MakerMatrix/IndyMill/IndyController/changelog.txt

04.11.2021:
OR gate added to the diag pins and connected to the microcontroller. Thicker traces for VIN and some signals. Now it's just about perfecting the design and adding more features.

31.10.2021:
I simplified the whole schematic and got rid of additional screw terminals for external stepper drivers, start, hold and resum buttons (to have some additional free pins on the microcontroller). I will use those pins to handle DIAG pins of the drivers, there will be an OR gate for X, Y1 and Z axis as we will home only one at a time but Y2 will be connected separetely so that we can properly square the CNC.
I started routing some more components on the PCB, it's going well.

4.10.2021:
I just thought that it may be a good idea to just note down the thoughts while designing this project. Here I will write down what I changed, new ideas and other stuff connected to the IndyController.

For the last few days I have been thinking about it a lot, I think I am going to change the concept and instead of designing a controller board for IndyMill I will design a new controller board for smaller CNC machines like Dremel CNC and in the future a new CNC that I want to start working on. IndyShield is good enough for IndyMill. By implementing TMC drivers I can simplify the construction of a CNC create a really inteligent control board powered with 24V. I will have to customize GRBL quite a lot.
