MakerMatrix/IndyMill/IndyController/parts.ods

Name | Value | Amount | Link | Comment
CH340G | - | 1 | https://lcsc.com/product-detail/USB-ICs_WCH-Jiangsu-Qin-Heng-CH340G_C14267.html
USB B socket | - | 1 | https://lcsc.com/product-detail/span-style-background-color-ff0-USB-span-Connectors_Ckmtw-Shenzhen-Cankemeng-U-USBBR04P-F000_C189733.html
Resistor (0603) | 10k | 3
Capacitor (0603) | 10uF | 1
Electrolytic capacitor | 10uF | 2 | https://lcsc.com/product-detail/Aluminum-Electrolytic-Capacitors-Leaded_PANASONIC-ECEA1VKS100_C713348.html
Screw Terminal | 4 pin | 3 | https://lcsc.com/product-detail/Screw-terminal_JILN-JL301-50004U01_C1509680.html
Screw Terminal | 3 pin |  | https://lcsc.com/product-detail/Screw-terminal_JILN-JL301-50003U01_C395215.html
Screw Terminal | 2 pin |  | https://lcsc.com/product-detail/Screw-terminal_JILN-JL301-50002U02_C395214.html
FDN340P P MOSFET |  | 1 | https://lcsc.com/product-detail/MOSFETs_UMW-Youtai-Semiconductor-Co-Ltd-FDN340P_C347510.html
LM358D opamp |  | 2 | https://lcsc.com/product-detail/Operational-Amplifier_IDCHIP-LM358D_C688858.html
Crystal 16MHz
Crystal 12MHz
Fuse holder | 5x20mm | 1 | https://www.lcsc.com/product-detail/span-style-background-color-ff0-Fuse-span-Holders_Littelfuse-0PTF0078P_C2760101.html
Fuse 500mA 5x20mm | 5x20mm | 1 | https://www.lcsc.com/product-detail/Fuses_Littelfuse-0217-500MXP_C142795.html
Fuse 2A 5x20mm | 5x20mm | 1 | https://www.lcsc.com/product-detail/Fuses_Littelfuse-0218002-MXP_C142702.html
Polarity protection diode | 40V, 1A | 1 | https://www.lcsc.com/product-detail/Schottky-Barrier-Diodes-SBD_Diodes-Incorporated-B140-13-F_C15759.html
5V regulator IFX27001TF V50 |  | 1 | https://www.lcsc.com/product-detail/Linear-Voltage-Regulators-LDO_Infineon-Technologies-IFX27001TF-V50_C152661.html
3.3V regulator LP2985-33DBVR |  | 1 | https://www.lcsc.com/product-detail/Linear-Voltage-Regulators-LDO_Texas-Instruments-LP2985-33DBVR_C95414.html
12V regulator LM3480IM3-12/NOPB | 12V, 100mA | 1 | https://www.lcsc.com/product-detail/Linear-Voltage-Regulators-LDO_Texas-Instruments-LM3480IM3-12-NOPB_C130175.html
TMC2226-SA-T | 2A | 4 | https://lcsc.com/product-detail/Motor-Driver-ICs_TRINAMIC-Motion-Control-GmbH-TMC2226-SA-T_C705366.html
JST Connector | 2 pin | 5 | https://lcsc.com/product-detail/Wire-To-Board-Wire-To-Wire-Connector_BOOMELE-Boom-Precision-Elec-C24194_C24194.html
OR JST Connector | - | - | https://lcsc.com/product-detail/Wire-To-Board-Wire-To-Wire-Connector_BOOMELE-Boom-Precision-Elec-C24192_C24192.html
OR JST Connector | - | - | https://lcsc.com/product-detail/Wire-To-Board-Wire-To-Wire-Connector_BOOMELE-Boom-Precision-Elec-C57141_C57141.html
JST Connector | 3 pin | 1 | https://lcsc.com/product-detail/Wire-To-Board-Wire-To-Wire-Connector_BOOMELE-Boom-Precision-Elec-C95019_C95019.html
OR gate | 3 inputs | 1 | https://lcsc.com/product-detail/Gates_Texas-Instruments-SN74LVC1G332DBVR_C43368.html
ADDITIONAL | 2 pin | a lot | https://lcsc.com/product-detail/Rectangular-Connectors-Housings_BOOMELE-Boom-Precision-Elec-XHB-2Y_C57102.html
ADDITIONAL | 2 pin | a lot | https://lcsc.com/product-detail/Rectangular-Connectors-Housings_BOOMELE-Boom-Precision-Elec-XH-2Y_C8677.html
