MakerMatrix/IndyMill/3D Printed/X axis nut holder.stl

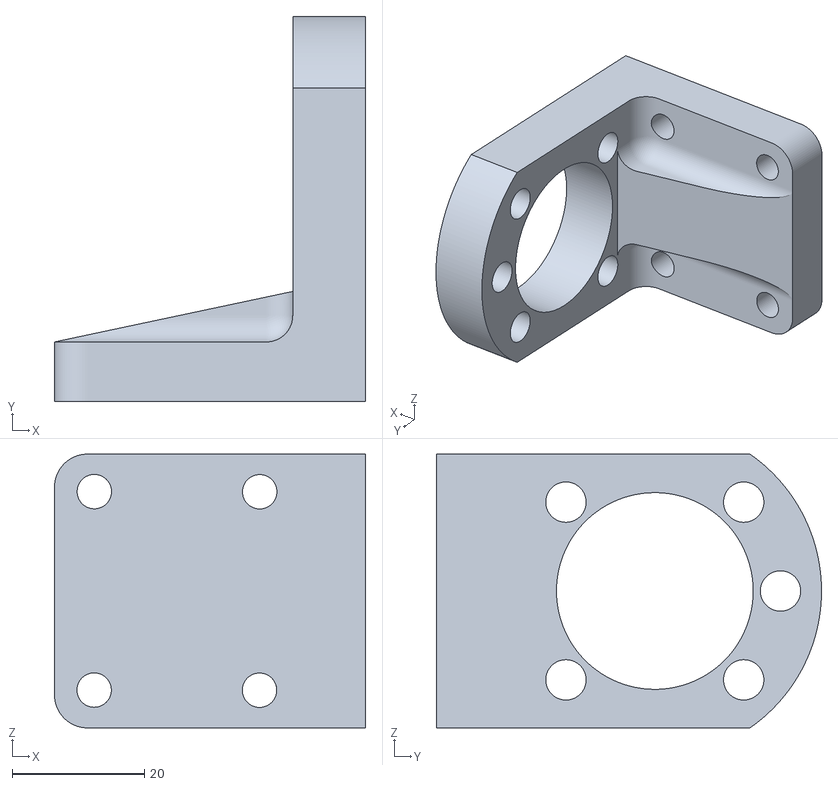
[picture p1: CAD file, 2022-02-04]
3D Printed/X axis nut holder.stl
47.0 x 58.2 x 41.4
