MakerMatrix/IndyMill/IndyController/1811131826_Ckmtw-Shenzhen-Cankemeng-U-USBBR04P-F000_C189733.pdf

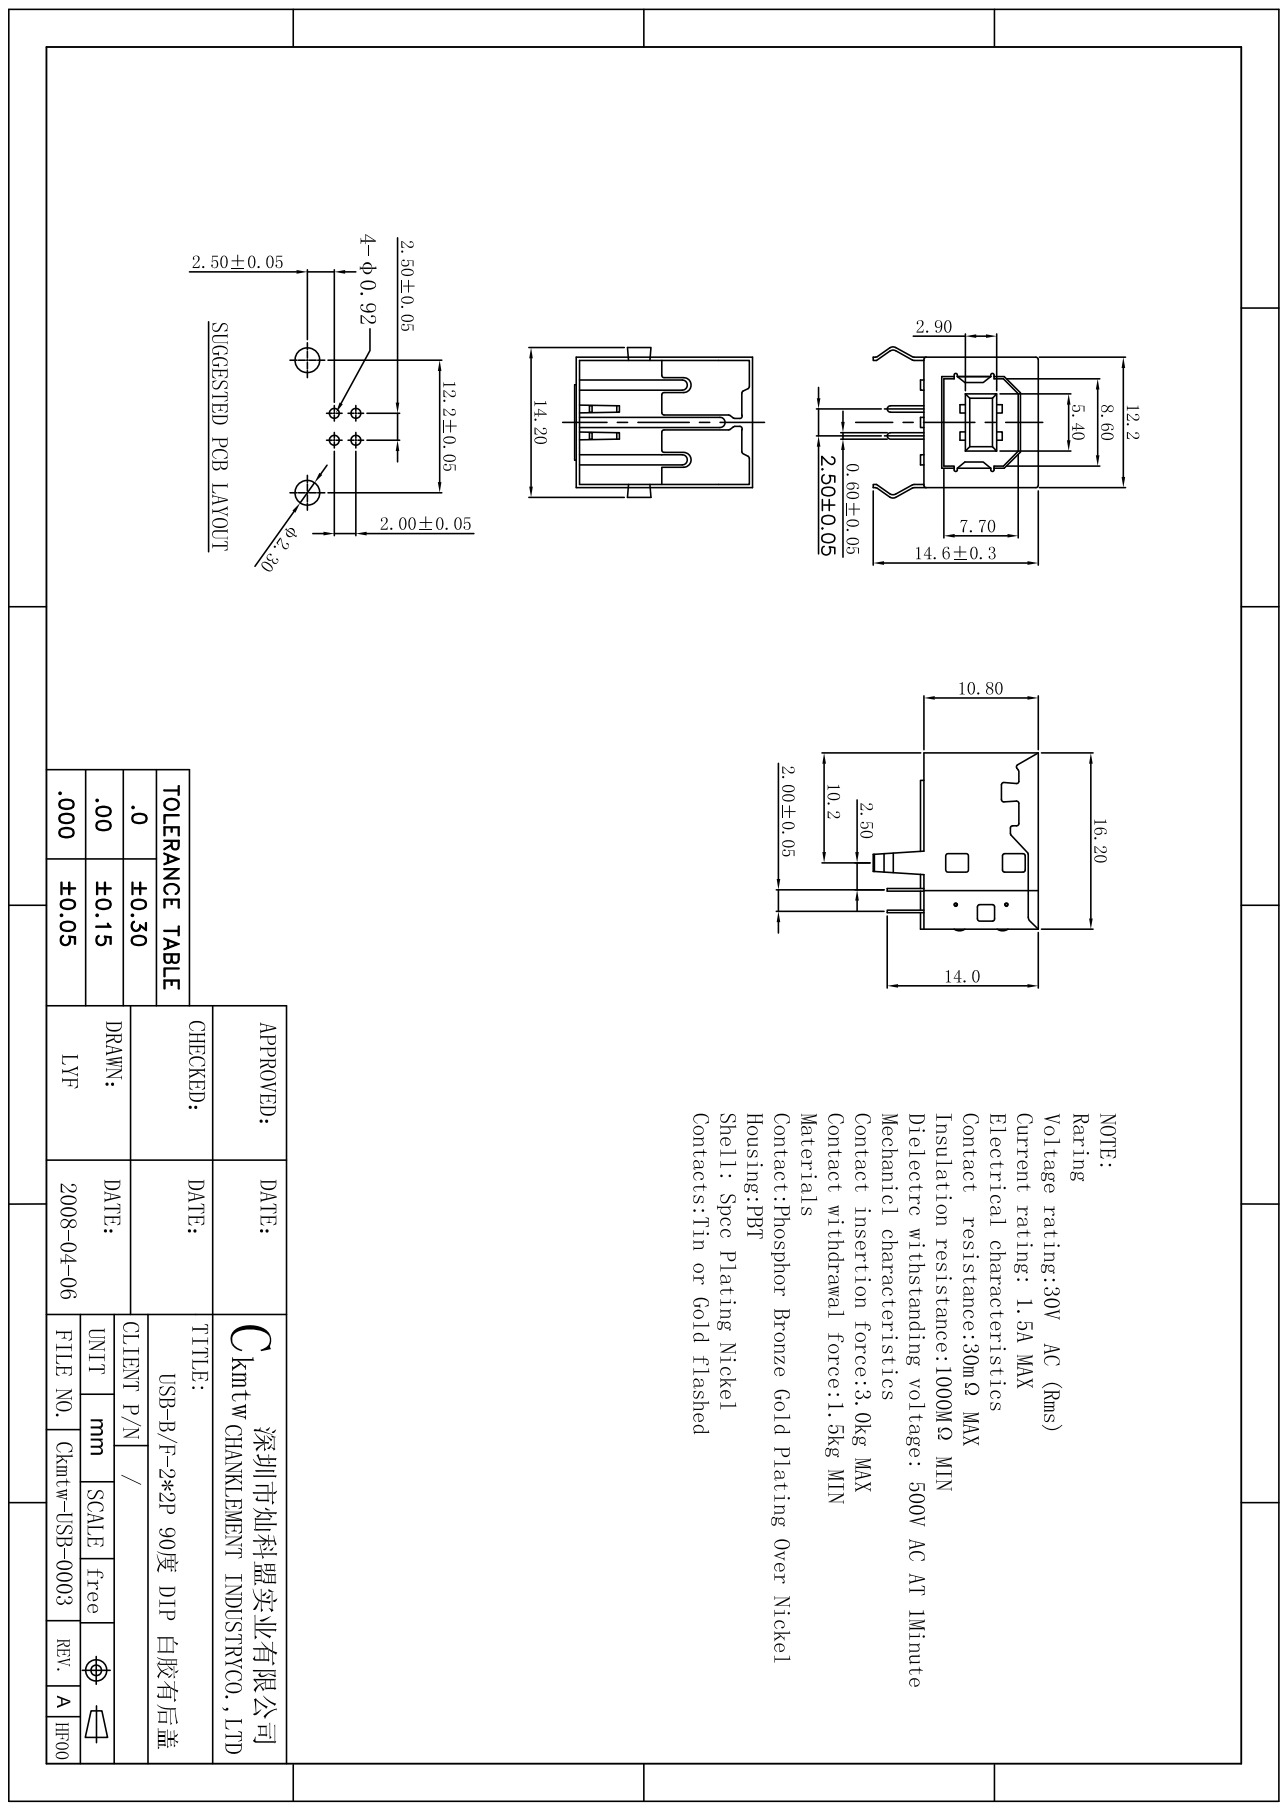
[picture p2: page 1]
