MakerMatrix/IndyMill/IndyController/schematic.brd

## EAGLE design IndyController/schematic.brd (2021-11-05)

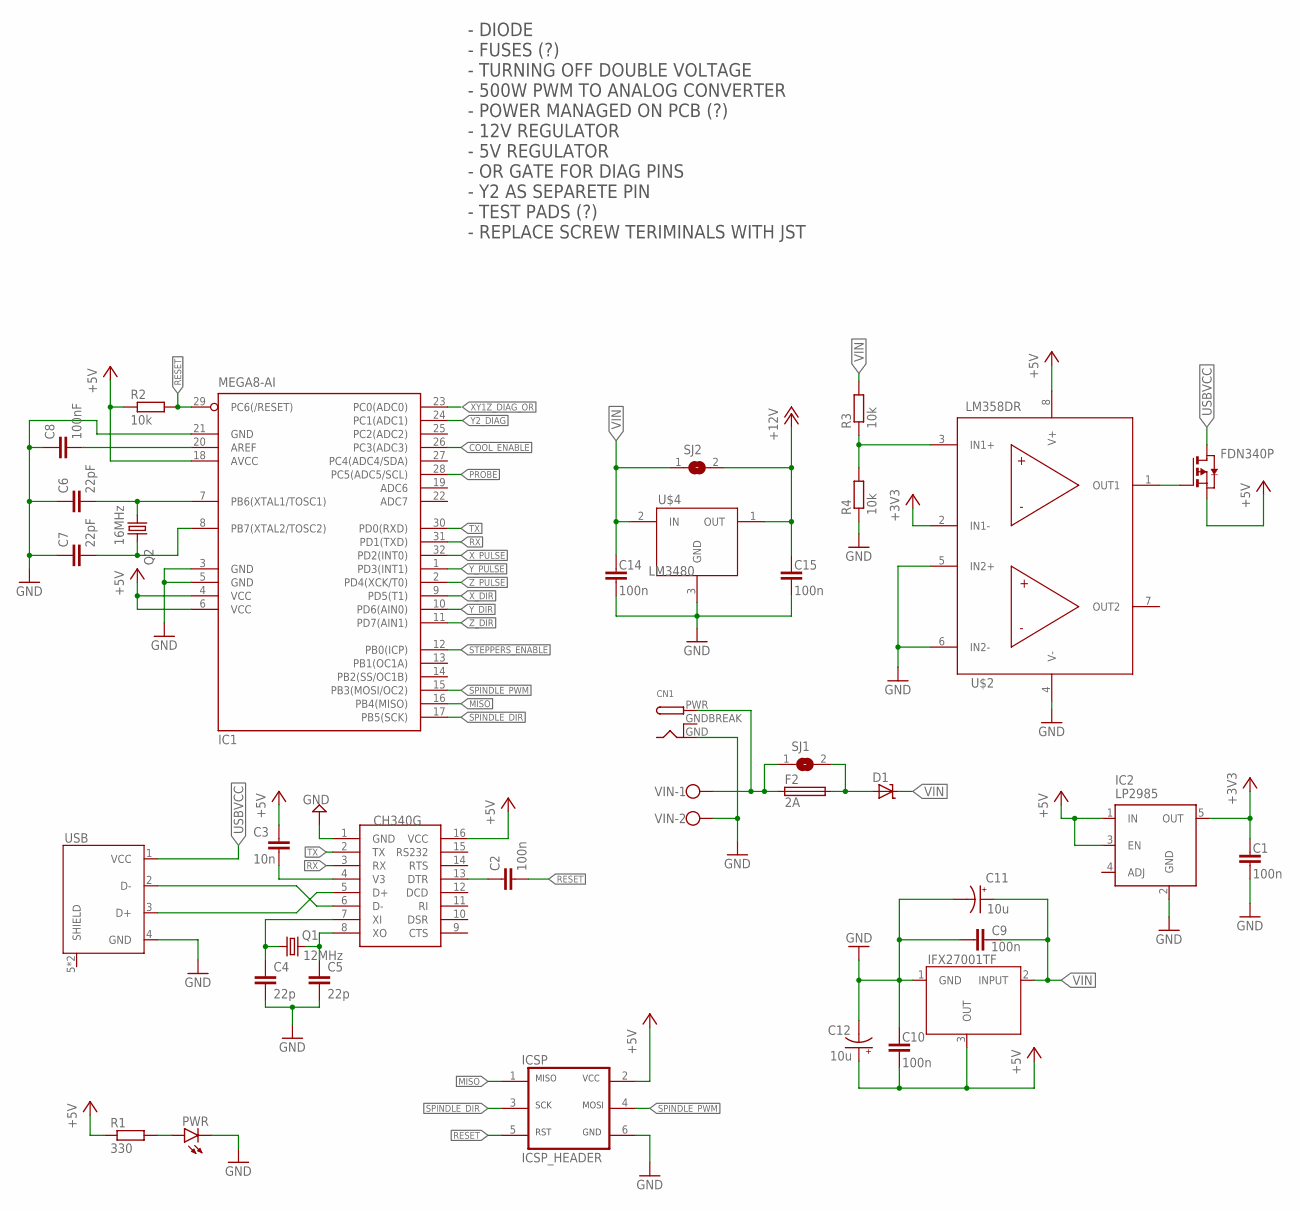
[picture p3: schematic schematic.sch, sheet 1]

Parts:
C1, C2, C9, C10, C14, C15: 100n; C0603
C3: 10n; C0603
C4, C5: 22p; C0603
C6, C7: 22pF; C0603
C8: 100nF; C0603
C11, C12: 10u; E5-5
CN1: DCBARRELPTH; DCJACK_2MM_PTH
D1: SD-SMA; SMA
F2: 2A; GSH15
FDN340P: FDN340PSOT23; SOT95P240X110-3N
IC1: MEGA8-AI; TQFP32-08
IC2: LP2985; SOT23-5
IFX27001TF: IFX27001TFV50TO252; TO228P998X230-3N
PWR: LEDCHIPLED_0805; CHIPLED_0805
Q1: 12MHz; 5.0X3.2_2
Q2: 16MHz; 5.0X3.2_2
R1: 330; R0603
R2, R3, R4: 10k; R0603
SJ1: SJW
SJ2: SJ
U$1: CH340G; SOIC16
U$2: LM358; SOIC127P599X175-8N
U$4: LM3480; SOT95P247X112-3N
U$6: ICSP_HEADER
USB: U-USBBR04P-F000
VIN: W237-102

Connections:
+3V3: C1.2, IC2.5 (OUT), U$2.2 (IN1-)
+5V: C3.1, C10.1, C12.+, FDN340P.2 (S), IC1.4 (VCC), IC1.6 (VCC), IC1.18 (AVCC), IC2.1 (IN), IC2.3 (EN), IFX27001TF.3 (OUT), R1.1, R2.1, U$1.16 (VCC), U$2.8 (V+), U$6.2 (VCC); also elsewhere on the board
+12V: C15.2, SJ2.2, U$4.1 (OUT); also elsewhere on the board
COOL_ENABLE: IC1.26 (PC3(ADC3)); also elsewhere on the board
GND: C1.1, C4.2, C5.2, C6.1, C7.1, C8.1, C9.1, C10.2, C11.-, C12.-, C14.1, C15.1, CN1.GND, IC1.3 (GND), IC1.5 (GND), IC1.21 (GND), IC2.2 (GND), IFX27001TF.1 (GND), PWR.C, R4.1, U$1.1 (GND), U$2.4 (V-), U$2.5 (IN2+), U$2.6 (IN2-), U$4.3 (GND), U$6.6 (GND), USB.4 (GND), VIN.2; also elsewhere on the board
GNDBREAK: CN1.GNDBREAK
MISO: IC1.16 (PB4(MISO)), U$6.1 (MISO)
unnamed: C3.2, U$1.4 (V3)
unnamed: C2.1, U$1.13 (DTR)
unnamed: C5.1, Q1.2, U$1.8 (XO)
unnamed: C4.1, Q1.1, U$1.7 (XI)
unnamed: U$1.6 (D-), USB.2 (D-)
unnamed: PWR.A, R1.2
unnamed: C6.2, IC1.7 (PB6(XTAL1/TOSC1)), Q2.1
unnamed: C7.2, IC1.8 (PB7(XTAL2/TOSC2)), Q2.2
unnamed: C8.2, IC1.20 (AREF)
unnamed: U$1.5 (D+), USB.3 (D+)
unnamed: FDN340P.1 (G), U$2.1 (OUT1)
unnamed: CN1.PWR, F2.1, SJ1.1, VIN.1
unnamed: R3.1, R4.2, U$2.3 (IN1+)
unnamed: D1.A, F2.2, SJ1.2
PROBE: IC1.28 (PC5(ADC5/SCL)); also elsewhere on the board
RESET: C2.2, IC1.29 (PC6(/RESET)), R2.2, U$6.5 (RST)
RX: IC1.31 (PD1(TXD)), U$1.3 (RX)
SPINDLE_DIR: IC1.17 (PB5(SCK)), U$6.3 (SCK); also elsewhere on the board
SPINDLE_PWM: IC1.15 (PB3(MOSI/OC2)), U$6.4 (MOSI); also elsewhere on the board
STEPPERS_ENABLE: IC1.12 (PB0(ICP)); also elsewhere on the board
TX: IC1.30 (PD0(RXD)), U$1.2 (TX)
USBVCC: FDN340P.3 (D), USB.1 (VCC)
VIN: C9.2, C11.+, C14.2, D1.C, IFX27001TF.2 (INPUT), R3.2, SJ2.1, U$4.2 (IN); also elsewhere on the board
XY1Z_DIAG_OR: IC1.23 (PC0(ADC0)); also elsewhere on the board
X_DIR: IC1.9 (PD5(T1)); also elsewhere on the board
X_PULSE: IC1.32 (PD2(INT0)); also elsewhere on the board
Y2_DIAG: IC1.24 (PC1(ADC1)); also elsewhere on the board
Y_DIR: IC1.10 (PD6(AIN0)); also elsewhere on the board
Y_PULSE: IC1.1 (PD3(INT1)); also elsewhere on the board
Z_DIR: IC1.11 (PD7(AIN1)); also elsewhere on the board
Z_PULSE: IC1.2 (PD4(XCK/T0)); also elsewhere on the board

Notes on the sheet:
- DIODE - FUSES (?) - TURNING OFF DOUBLE VOLTAGE - 500W PWM TO ANALOG CONVERTER - POWER MANAGED ON PCB (?) - 12V REGULATOR - 5V REGULATOR - OR GATE FOR DIAG PINS - Y2 AS SEPARETE PIN - TEST PADS (?) - REPLACE SCREW TERIMINALS WITH JST

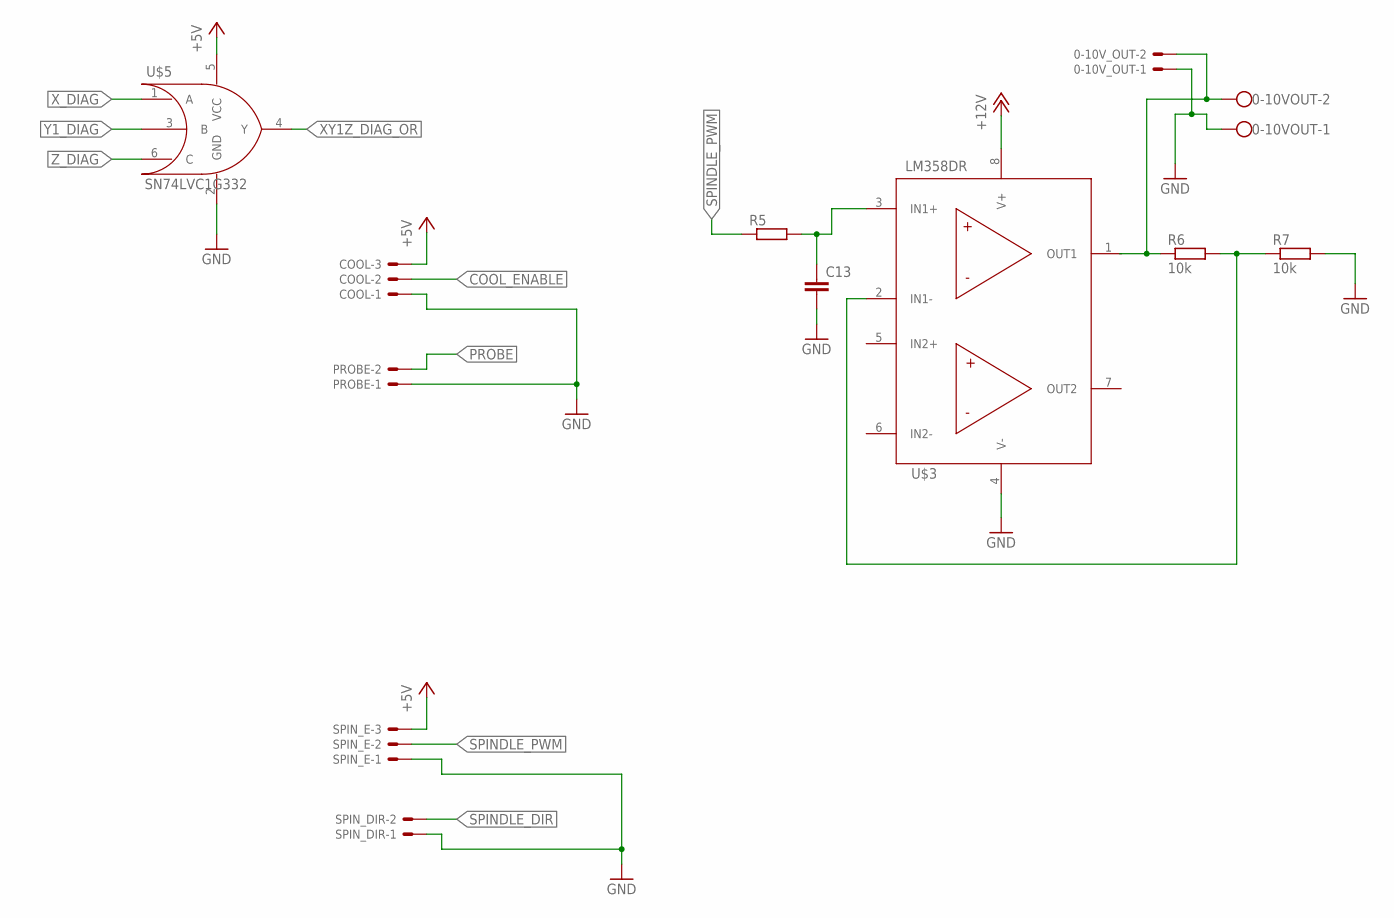
[picture p4: schematic schematic.sch, sheet 2]

Parts:
0-10VOUT: W237-102
0-10V_OUT: JST-XH-02-PIN-LONG-PAD; JST-XH-02-PACKAGE-LONG-PAD
C13: C-EUC0603; C0603
COOL: JST-XH-03-PIN-LONG-PAD; JST-XH-03-PACKAGE-LONG-PAD
PROBE: JST-XH-02-PIN-LONG-PAD; JST-XH-02-PACKAGE-LONG-PAD
R5: R-EU_R0603; R0603
R6, R7: 10k; R0603
SPIN_DIR: JST-XH-02-PIN-LONG-PAD; JST-XH-02-PACKAGE-LONG-PAD
SPIN_E: JST-XH-03-PIN-LONG-PAD; JST-XH-03-PACKAGE-LONG-PAD
U$3: LM358; SOIC127P599X175-8N
U$5: SN74LVC1G332; SOT95P280X110-6N

Connections:
+5V: COOL.3, SPIN_E.3, U$5.5 (VCC); also elsewhere on the board
+12V: U$3.8 (V+); also elsewhere on the board
COOL_ENABLE: COOL.2; also elsewhere on the board
GND: 0-10VOUT.1, 0-10V_OUT.1, C13.2, COOL.1, PROBE.1, R7.2, SPIN_DIR.1, SPIN_E.1, U$3.4 (V-), U$5.2 (GND); also elsewhere on the board
unnamed: C13.1, R5.2, U$3.3 (IN1+)
unnamed: R6.2, R7.1, U$3.2 (IN1-)
unnamed: 0-10VOUT.2, 0-10V_OUT.2, R6.1, U$3.1 (OUT1)
PROBE: PROBE.2; also elsewhere on the board
SPINDLE_DIR: SPIN_DIR.2; also elsewhere on the board
SPINDLE_PWM: R5.1, SPIN_E.2; also elsewhere on the board
XY1Z_DIAG_OR: U$5.4 (Y); also elsewhere on the board
X_DIAG: U$5.1 (A); also elsewhere on the board
Y1_DIAG: U$5.3 (B); also elsewhere on the board
Z_DIAG: U$5.6 (C); also elsewhere on the board

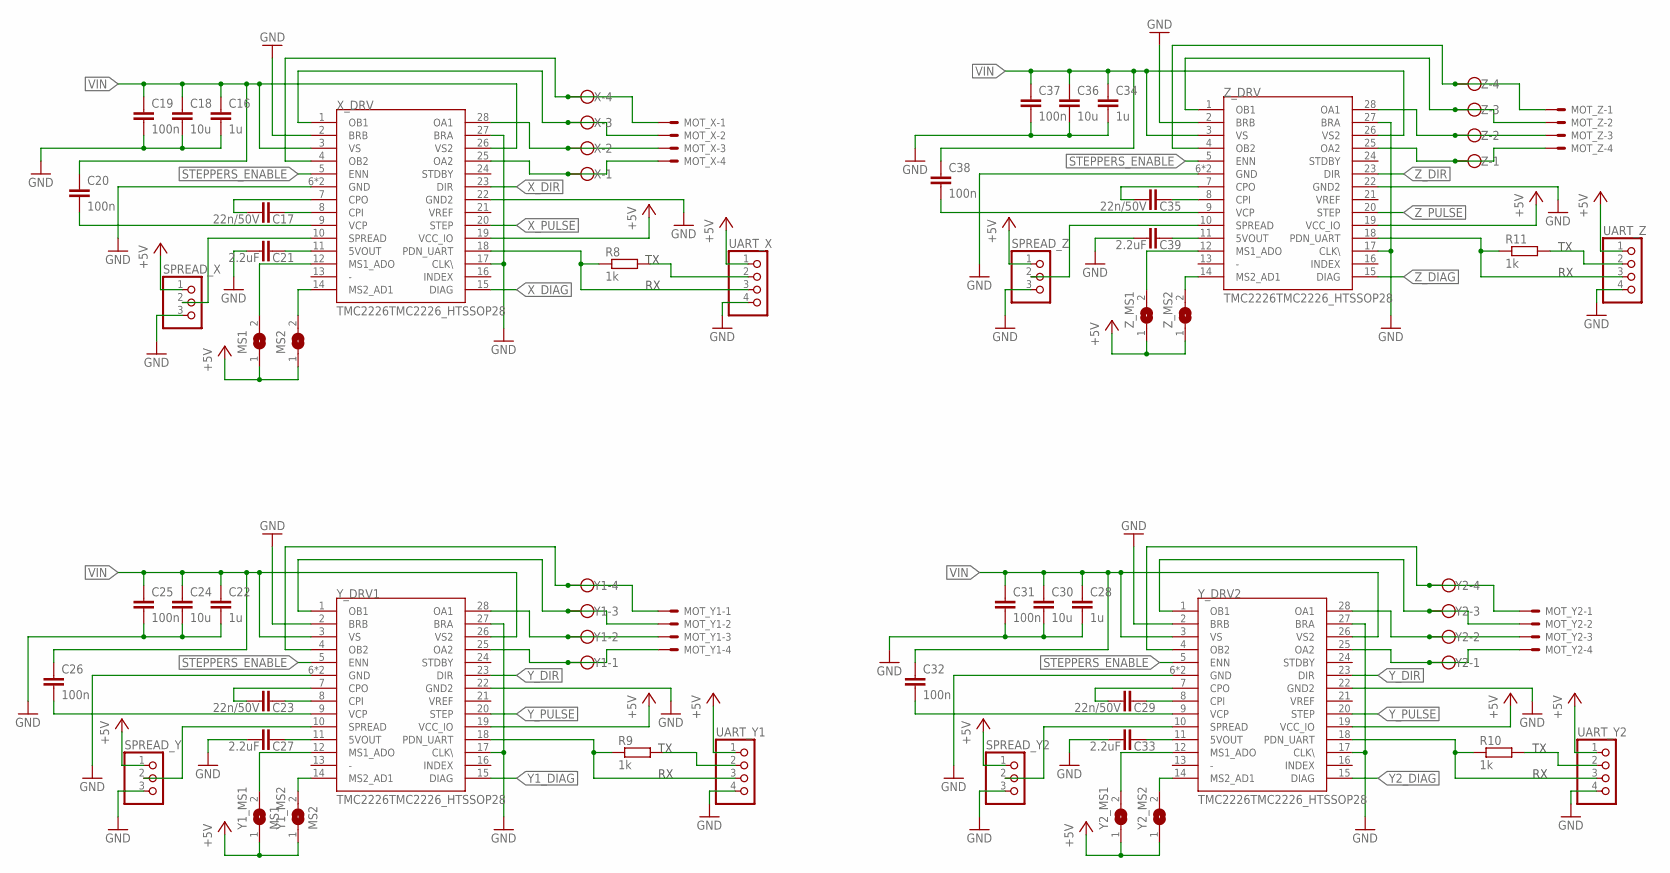
[picture p5: schematic schematic.sch, sheet 3]

Parts:
C16, C22, C28, C34: 1u; C0603
C17, C23, C29, C35: 22n/50V; C0603
C18, C24, C30, C36: 10u; C0603
C19, C20, C25, C26, C31, C32, C37, C38: 100n; C0603
C21, C27, C33, C39: 2.2uF; C0603
MOT_X: JST-XH-04-PIN-LONG-PAD; JST-XH-04-PACKAGE-LONG-PAD
MOT_Y1, MOT_Y2: JST-XH-04-PIN-LONG-PAD; JST-XH-04-PACKAGE-LONG-PAD
MOT_Z: JST-XH-04-PIN-LONG-PAD; JST-XH-04-PACKAGE-LONG-PAD
MS1, MS2: SJ
R8, R9, R10, R11: 1k; R0603
SPREAD_X: PINHD-1X3; 1X03
SPREAD_Y, SPREAD_Y2: PINHD-1X3; 1X03
SPREAD_Z: PINHD-1X3; 1X03
UART_X: PINHD-1X4; 1X04
UART_Y1, UART_Y2: PINHD-1X4; 1X04
UART_Z: PINHD-1X4; 1X04
X: W237-4
X_DRV: TMC2226TMC2226_HTSSOP28; SOP65P640X120-29T275X620N
Y1, Y2: W237-4
Y1_MS1: MS1; SJ
Y1_MS2: MS2; SJ
Y2_MS1, Y2_MS2: SJ
Y_DRV1, Y_DRV2: TMC2226TMC2226_HTSSOP28; SOP65P640X120-29T275X620N
Z: W237-4
Z_DRV: TMC2226TMC2226_HTSSOP28; SOP65P640X120-29T275X620N
Z_MS1, Z_MS2: SJ

Connections:
+5V: MS1.1, MS2.1, SPREAD_X.1, SPREAD_Y.1, SPREAD_Y2.1, SPREAD_Z.1, UART_X.1, UART_Y1.1, UART_Y2.1, UART_Z.1, X_DRV.19 (VCC_IO), Y1_MS1.1, Y1_MS2.1, Y2_MS1.1, Y2_MS2.1, Y_DRV1.19 (VCC_IO), Y_DRV2.19 (VCC_IO), Z_DRV.19 (VCC_IO), Z_MS1.1, Z_MS2.1; also elsewhere on the board
GND: C16.2, C18.2, C19.2, C21.1, C22.2, C24.2, C25.2, C27.1, C28.2, C30.2, C31.2, C33.1, C34.2, C36.2, C37.2, C39.1, SPREAD_X.3, SPREAD_Y.3, SPREAD_Y2.3, SPREAD_Z.3, UART_X.4, UART_Y1.4, UART_Y2.4, UART_Z.4, X_DRV.2 (BRB), X_DRV.6 (GND), X_DRV.17 (CLK\), X_DRV.22 (GND2), X_DRV.27 (BRA), X_DRV.29 (GND), Y_DRV1.2 (BRB), Y_DRV1.6 (GND), Y_DRV1.17 (CLK\), Y_DRV1.22 (GND2), Y_DRV1.27 (BRA), Y_DRV1.29 (GND), Y_DRV2.2 (BRB), Y_DRV2.6 (GND), Y_DRV2.17 (CLK\), Y_DRV2.22 (GND2), Y_DRV2.27 (BRA), Y_DRV2.29 (GND), Z_DRV.2 (BRB), Z_DRV.6 (GND), Z_DRV.17 (CLK\), Z_DRV.22 (GND2), Z_DRV.27 (BRA), Z_DRV.29 (GND); also elsewhere on the board
unnamed: C17.2, X_DRV.8 (CPI)
unnamed: C17.1, X_DRV.7 (CPO)
unnamed: MOT_X.1, X.4, X_DRV.4 (OB2)
unnamed: MOT_X.2, X.3, X_DRV.1 (OB1)
unnamed: MOT_X.3, X.2, X_DRV.28 (OA1)
unnamed: MOT_X.4, X.1, X_DRV.25 (OA2)
unnamed: SPREAD_X.2, X_DRV.10 (SPREAD)
unnamed: C20.2, X_DRV.9 (VCP)
unnamed: C21.2, X_DRV.11 (5VOUT)
unnamed: R8.1, UART_X.3, X_DRV.18 (PDN_UART)
unnamed: MS1.2, X_DRV.12 (MS1_ADO)
unnamed: MS2.2, X_DRV.14 (MS2_AD1)
unnamed: R8.2, UART_X.2
unnamed: C23.2, Y_DRV1.8 (CPI)
unnamed: C23.1, Y_DRV1.7 (CPO)
unnamed: MOT_Y1.1, Y1.4, Y_DRV1.4 (OB2)
unnamed: MOT_Y1.2, Y1.3, Y_DRV1.1 (OB1)
unnamed: MOT_Y1.3, Y1.2, Y_DRV1.28 (OA1)
unnamed: MOT_Y1.4, Y1.1, Y_DRV1.25 (OA2)
unnamed: C26.2, Y_DRV1.9 (VCP)
unnamed: SPREAD_Y.2, Y_DRV1.10 (SPREAD)
unnamed: C27.2, Y_DRV1.11 (5VOUT)
unnamed: Y1_MS1.2, Y_DRV1.12 (MS1_ADO)
unnamed: Y1_MS2.2, Y_DRV1.14 (MS2_AD1)
unnamed: R9.1, UART_Y1.3, Y_DRV1.18 (PDN_UART)
unnamed: R9.2, UART_Y1.2
unnamed: C29.2, Y_DRV2.8 (CPI)
unnamed: C29.1, Y_DRV2.7 (CPO)
unnamed: MOT_Y2.1, Y2.4, Y_DRV2.4 (OB2)
unnamed: MOT_Y2.2, Y2.3, Y_DRV2.1 (OB1)
unnamed: MOT_Y2.3, Y2.2, Y_DRV2.28 (OA1)
unnamed: MOT_Y2.4, Y2.1, Y_DRV2.25 (OA2)
unnamed: C32.2, Y_DRV2.9 (VCP)
unnamed: SPREAD_Y2.2, Y_DRV2.10 (SPREAD)
unnamed: C33.2, Y_DRV2.11 (5VOUT)
unnamed: Y2_MS1.2, Y_DRV2.12 (MS1_ADO)
unnamed: Y2_MS2.2, Y_DRV2.14 (MS2_AD1)
unnamed: R10.1, UART_Y2.3, Y_DRV2.18 (PDN_UART)
unnamed: R10.2, UART_Y2.2
unnamed: C35.2, Z_DRV.8 (CPI)
unnamed: C35.1, Z_DRV.7 (CPO)
unnamed: MOT_Z.1, Z.4, Z_DRV.4 (OB2)
unnamed: MOT_Z.2, Z.3, Z_DRV.1 (OB1)
unnamed: MOT_Z.3, Z.2, Z_DRV.28 (OA1)
unnamed: MOT_Z.4, Z.1, Z_DRV.25 (OA2)
unnamed: C38.2, Z_DRV.9 (VCP)
unnamed: SPREAD_Z.2, Z_DRV.10 (SPREAD)
unnamed: C39.2, Z_DRV.11 (5VOUT)
unnamed: Z_DRV.12 (MS1_ADO), Z_MS1.2
unnamed: Z_DRV.14 (MS2_AD1), Z_MS2.2
unnamed: R11.1, UART_Z.3, Z_DRV.18 (PDN_UART)
unnamed: R11.2, UART_Z.2
STEPPERS_ENABLE: X_DRV.5 (ENN), Y_DRV1.5 (ENN), Y_DRV2.5 (ENN), Z_DRV.5 (ENN); also elsewhere on the board
VIN: C16.1, C18.1, C19.1, C20.1, C22.1, C24.1, C25.1, C26.1, C28.1, C30.1, C31.1, C32.1, C34.1, C36.1, C37.1, C38.1, X_DRV.3 (VS), X_DRV.26 (VS2), Y_DRV1.3 (VS), Y_DRV1.26 (VS2), Y_DRV2.3 (VS), Y_DRV2.26 (VS2), Z_DRV.3 (VS), Z_DRV.26 (VS2); also elsewhere on the board
X_DIAG: X_DRV.15 (DIAG); also elsewhere on the board
X_DIR: X_DRV.23 (DIR); also elsewhere on the board
X_PULSE: X_DRV.20 (STEP); also elsewhere on the board
Y1_DIAG: Y_DRV1.15 (DIAG); also elsewhere on the board
Y2_DIAG: Y_DRV2.15 (DIAG); also elsewhere on the board
Y_DIR: Y_DRV1.23 (DIR), Y_DRV2.23 (DIR); also elsewhere on the board
Y_PULSE: Y_DRV1.20 (STEP), Y_DRV2.20 (STEP); also elsewhere on the board
Z_DIAG: Z_DRV.15 (DIAG); also elsewhere on the board
Z_DIR: Z_DRV.23 (DIR); also elsewhere on the board
Z_PULSE: Z_DRV.20 (STEP); also elsewhere on the board

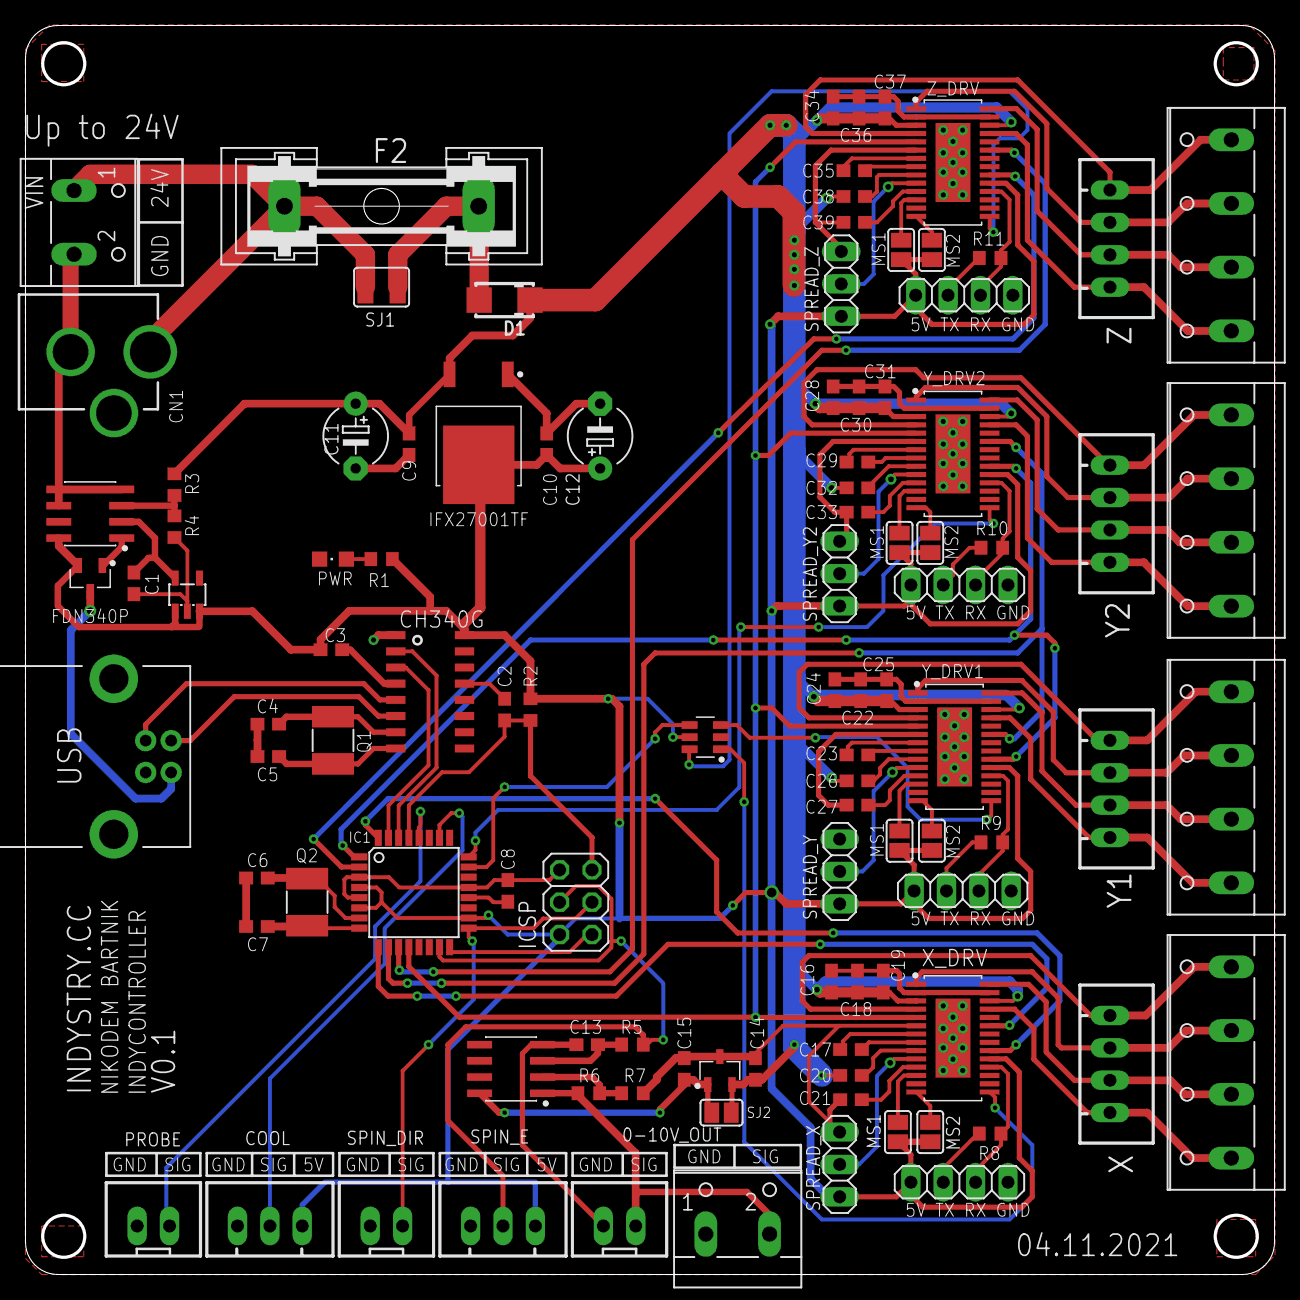
[picture p6: board schematic.brd from above]

Board: 2 copper layers, 98.0 x 98.0 mm, 104 parts (0 on the bottom side), 95 nets.
