MakerMatrix/IndyMill/Upgrades/500W Spindle PWM Converter/spindle_controller.brd

## EAGLE design Upgrades/500W Spindle PWM Converter/spindle_controller.brd (2021-09-07)

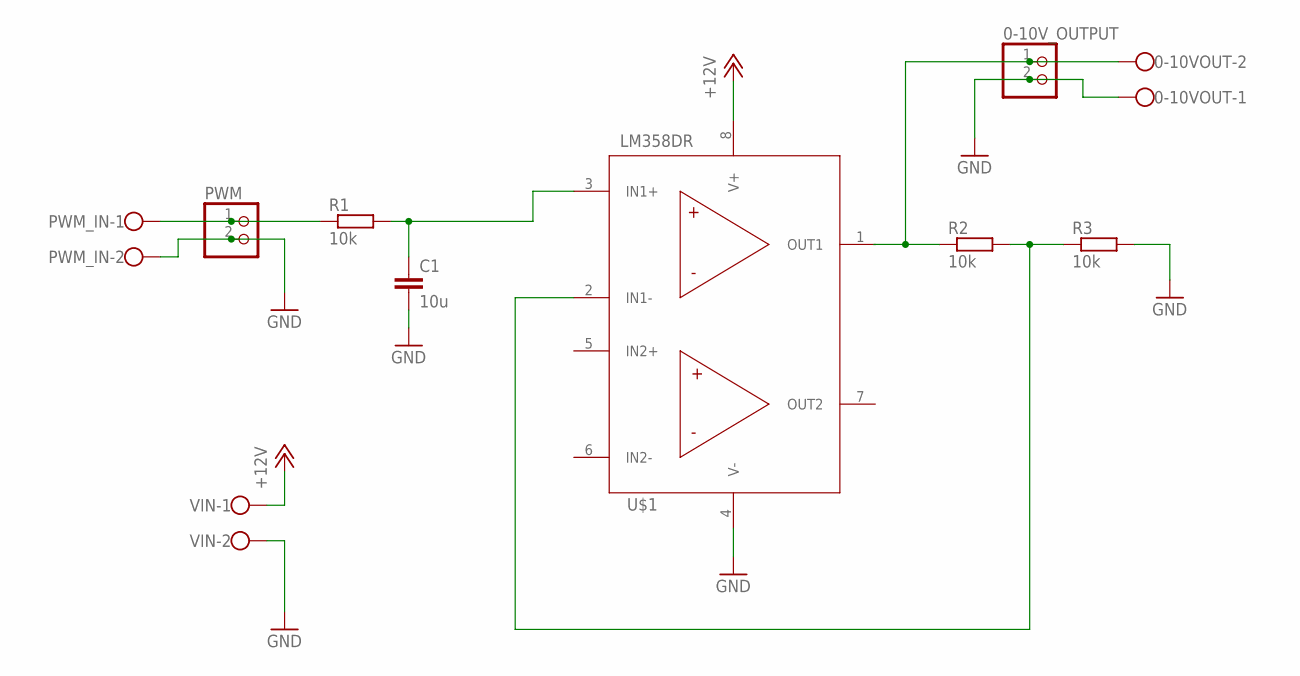
[picture p7: schematic spindle_controller.sch]

Parts:
0-10VOUT: W237-102
0-10V_OUTPUT: PINHD-1X2; 1X02
C1: 10u; C0603
PWM: PINHD-1X2; 1X02
PWM_IN: W237-102
R1, R2, R3: 10k; R0603
U$1: LM358DRLM358DR_SOIC8; SOIC127P599X175-8N
VIN: W237-102

Connections:
+12V: U$1.8 (V+), VIN.1
GND: 0-10VOUT.1, 0-10V_OUTPUT.2, C1.2, PWM.2, PWM_IN.2, R3.2, U$1.4 (V-), VIN.2
unnamed: PWM.1, PWM_IN.1, R1.1
unnamed: C1.1, R1.2, U$1.3 (IN1+)
unnamed: R2.2, R3.1, U$1.2 (IN1-)
unnamed: 0-10VOUT.2, 0-10V_OUTPUT.1, R2.1, U$1.1 (OUT1)

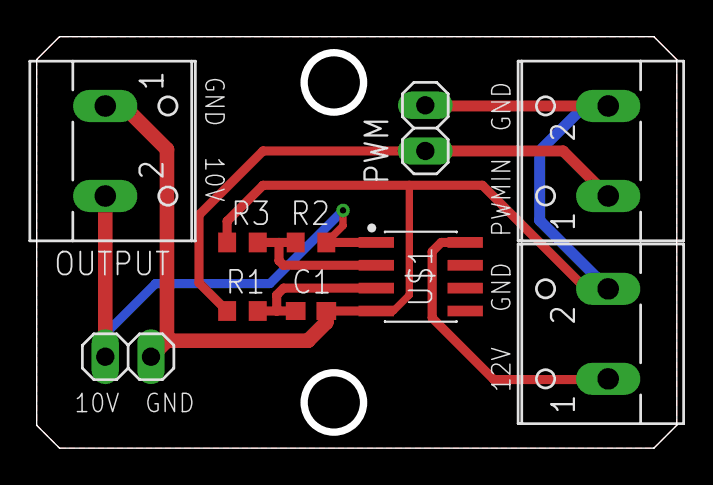
[picture p8: board spindle_controller.brd from above]

Board: 2 copper layers, 35.6 x 22.9 mm, 10 parts (0 on the bottom side), 6 nets.
