MakerMatrix/IndyMill/Upgrades/500W Spindle Light/spindle_light.brd

## EAGLE design Upgrades/500W Spindle Light/spindle_light.brd (2021-10-24)

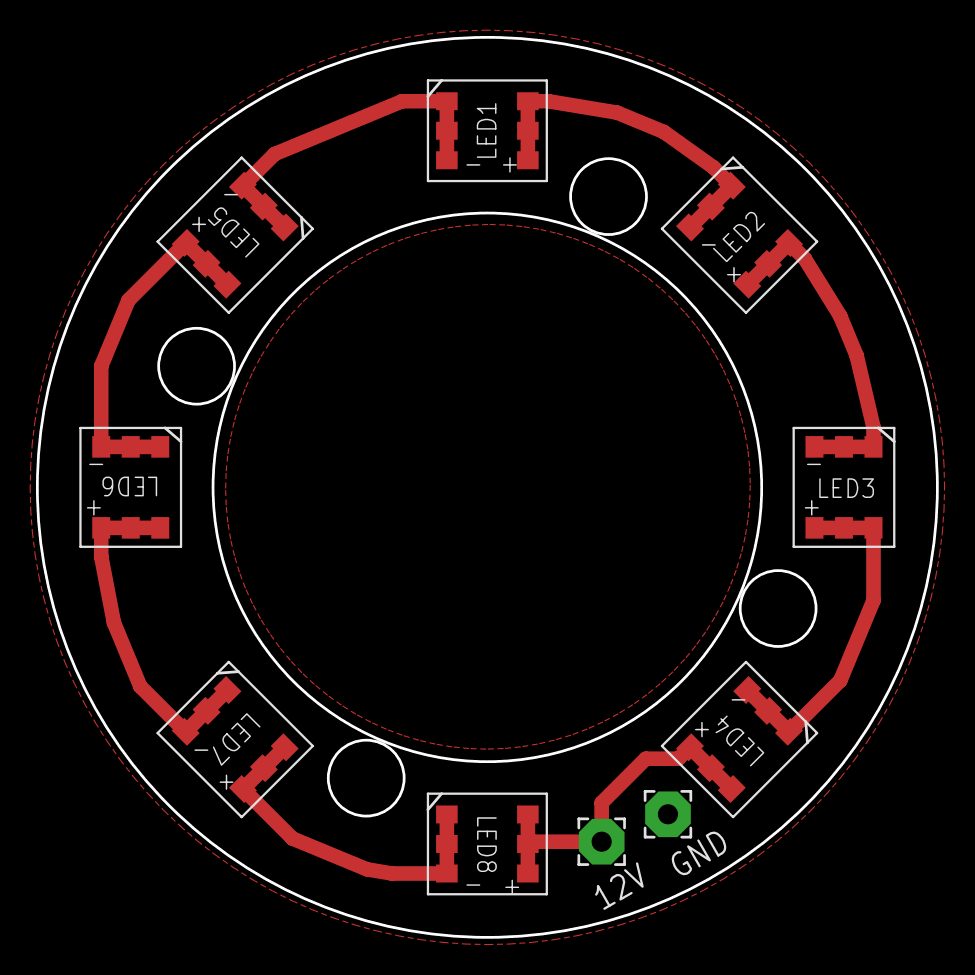
[picture p9: board spindle_light.brd from above]

Board: 2 copper layers, 50.0 x 50.0 mm, 10 parts (0 on the bottom side), 8 nets.

Parts:
12V: WIREPAD2,54/1,1; 2,54/1,1
GND: WIREPAD2,54/1,1; 2,54/1,1
LED1, LED2, LED3, LED4, LED5, LED6, LED7, LED8: RF-45HA50DS-EE-Y; 5050LED

Connections:
+12V: 12V.1, LED4.P$4, LED4.P$5, LED4.P$6, LED8.P$4, LED8.P$5, LED8.P$6
GND: GND.1, LED1.P$1, LED1.P$2, LED1.P$3, LED5.P$1, LED5.P$2, LED5.P$3
unnamed: LED5.P$4, LED5.P$5, LED5.P$6, LED6.P$1, LED6.P$2, LED6.P$3
unnamed: LED1.P$4, LED1.P$5, LED1.P$6, LED2.P$1, LED2.P$2, LED2.P$3
unnamed: LED2.P$4, LED2.P$5, LED2.P$6, LED3.P$1, LED3.P$2, LED3.P$3
unnamed: LED6.P$4, LED6.P$5, LED6.P$6, LED7.P$1, LED7.P$2, LED7.P$3
unnamed: LED7.P$4, LED7.P$5, LED7.P$6, LED8.P$1, LED8.P$2, LED8.P$3
unnamed: LED3.P$4, LED3.P$5, LED3.P$6, LED4.P$1, LED4.P$2, LED4.P$3
