MakerMatrix/IndyMill/(commit log)

2021-09-04 Add IndyController schematic and board file (work in progress)
    [parts.ods, schematic.brd, schematic.sch]
2021-09-05 Add 12V regulator, PCB layout
    [parts.ods, schematic.brd, schematic.sch]
2021-09-07 PCB cleanup and missing values added to schematic
    [spindle_controller.brd, spindle_controller.sch]
2021-10-04 Add TMC2226 to the schematic with datasheet, create changelog
    [parts.ods, schematic.brd, schematic.sch]
2021-10-24 Redesign spindle light
    Spindle light with bigger hole (30.5mm) to get it working with 1.5kW spindle too.
    [schematic.brd, schematic.sch, spindle_light.brd]
2021-10-30 Get rid of some components, connect TMC drivers almost completely
    [schematic.brd, schematic.sch]
2021-10-31 Add some connections and parts to the list
    [parts.ods, schematic.brd, schematic.sch]
2021-11-01 Ports redesign, final dimensions, most connections ready
    [parts.ods, schematic.brd, schematic.sch]
2021-11-01 JST connectors, polygons, final dimensions, screw holes
    [schematic.brd, schematic.sch]
2021-11-02 Cleanup + or gate datasheet
    [parts.ods, schematic.brd]
2021-11-04 Add OR gate, thicker traces
    [schematic.brd, schematic.sch]
2021-11-05 Final cleanup for V0.1!
    [schematic.brd]
2021-11-18 BOM update
    [parts.ods]
2022-02-04 Update X axis nut holder.stl
    [X axis nut holder.stl]
